fmario/pren_motst/assembly/Schematics_PREN23.PDF

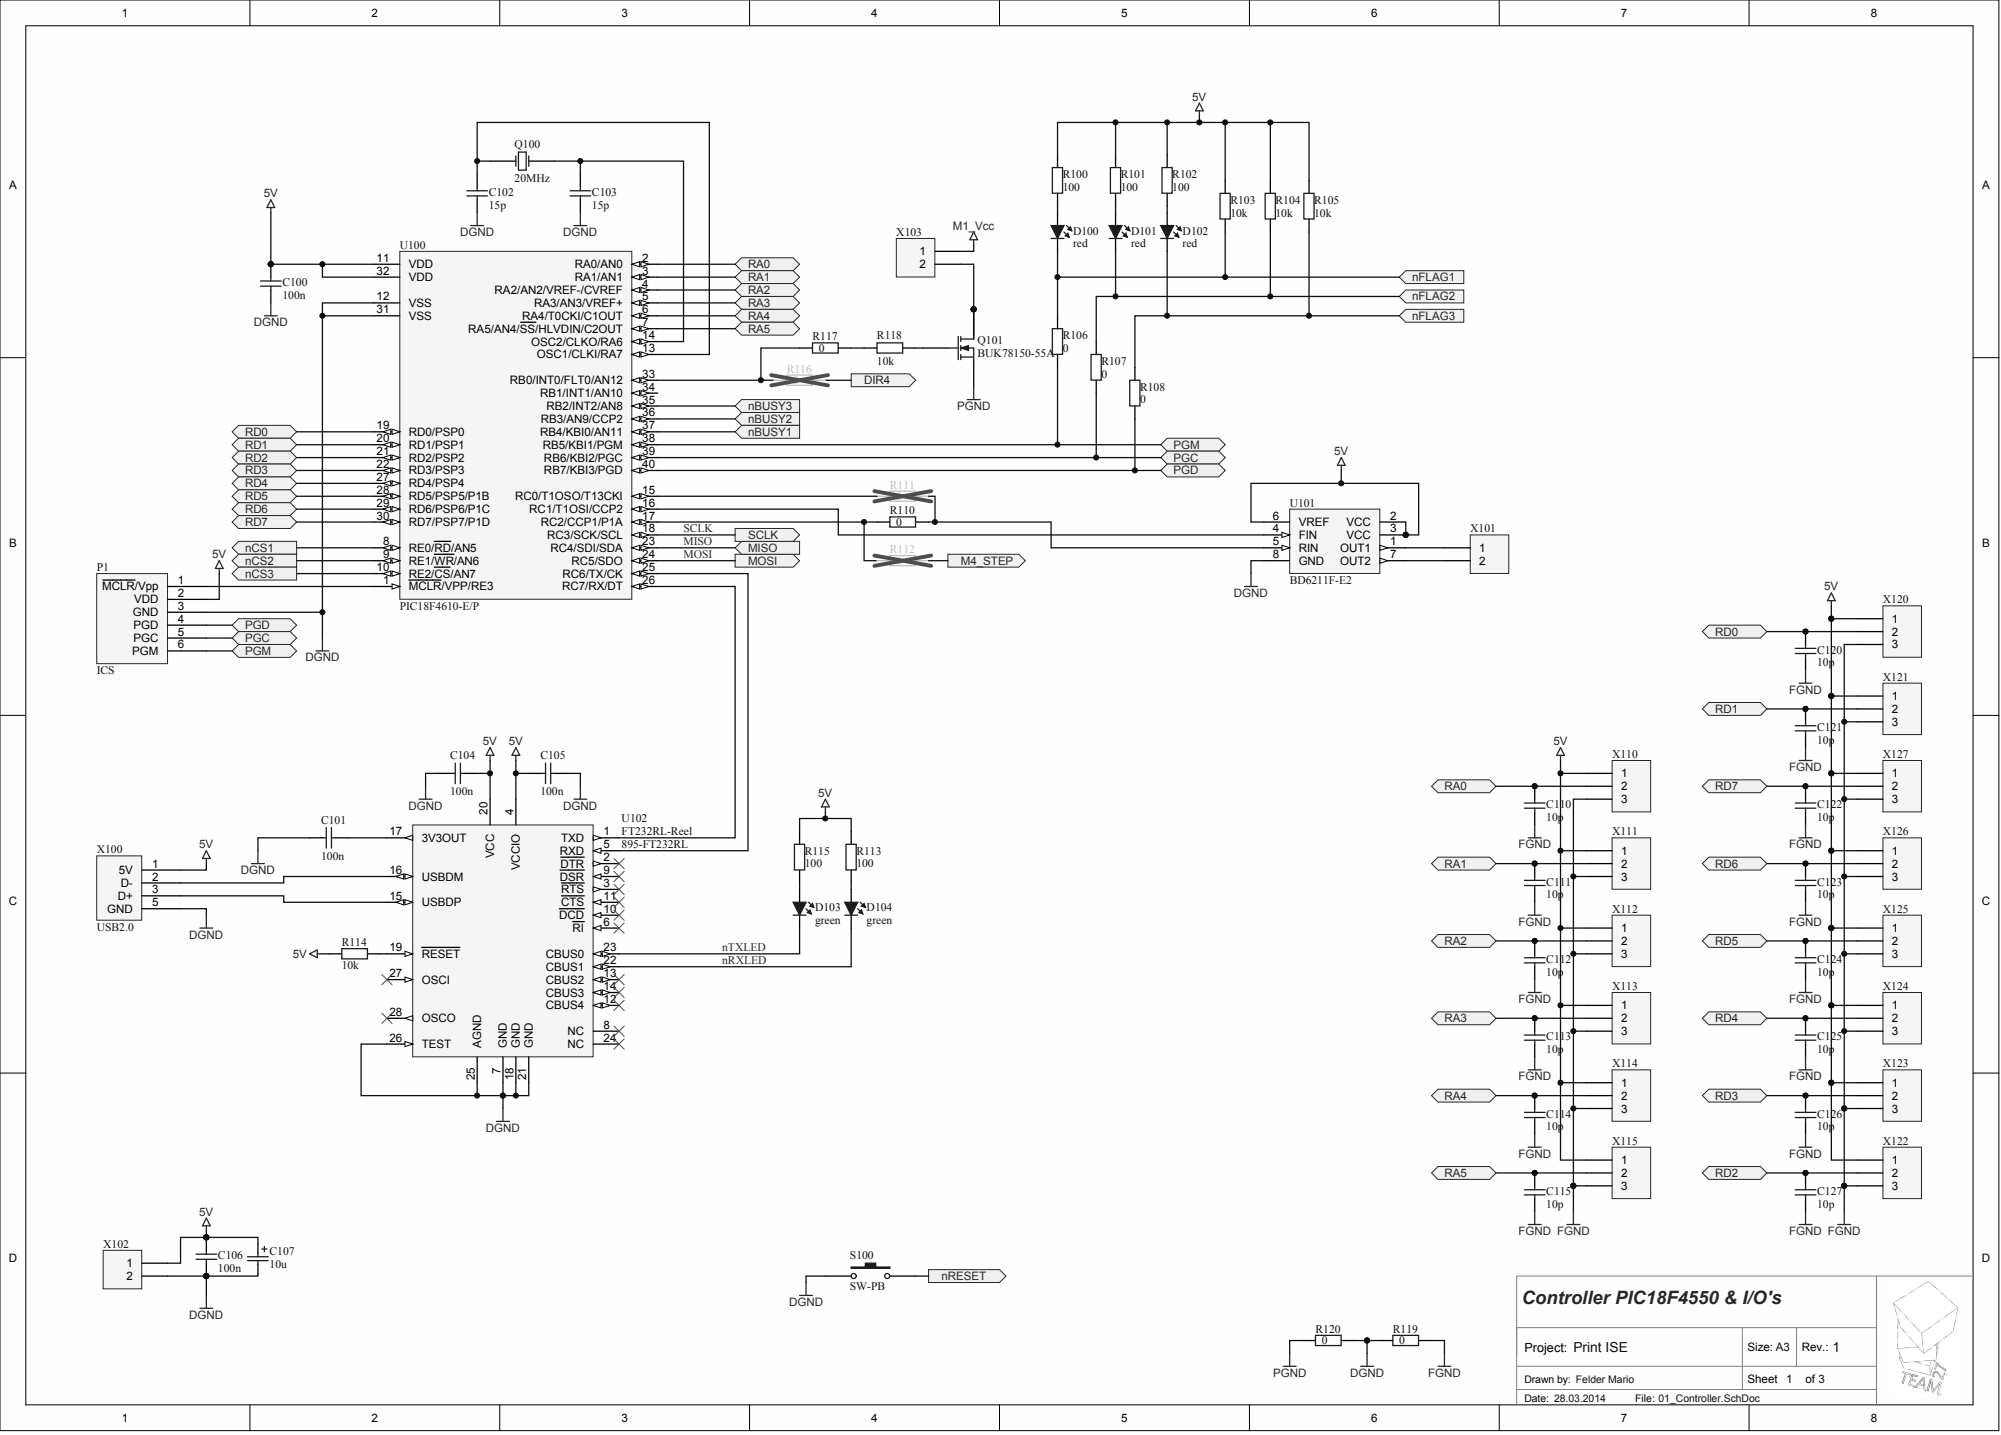
[picture p1: page 1]

20MHz C102 15p | | C103

VDD 11 RA5/AN4/SS/HLVDIN/C2OUT | RA2/AN2/VREF-/CVREF RA3/AN3/VREF+ RA4/T0CKI/C1OUT OSC1/CLKI/RA7 | RA1/AN1
VDD 32 | 3
VSS 12 | | | 4

VSS 31 | | 6
RD0/PSP0 19 RD1/PSP1 20 RD2/PSP2 21 RD3/PSP3 22 RD4/PSP4 27 RD5/PSP5/P1B 28 RD6/PSP6/P1C 29 RD7/PSP7/P1D 30 RE0/RD/AN5 8 RE1/WR/AN6 9 RE2/CS/AN7 10 MCLR/VPP/RE3 1 | 7

13 OSC2/CLKO/RA6 14

Controller PIC18F4550 & I/O's

Print ISE Project: | Size: A3 | 1 Rev.:

Drawn by: Felder Mario

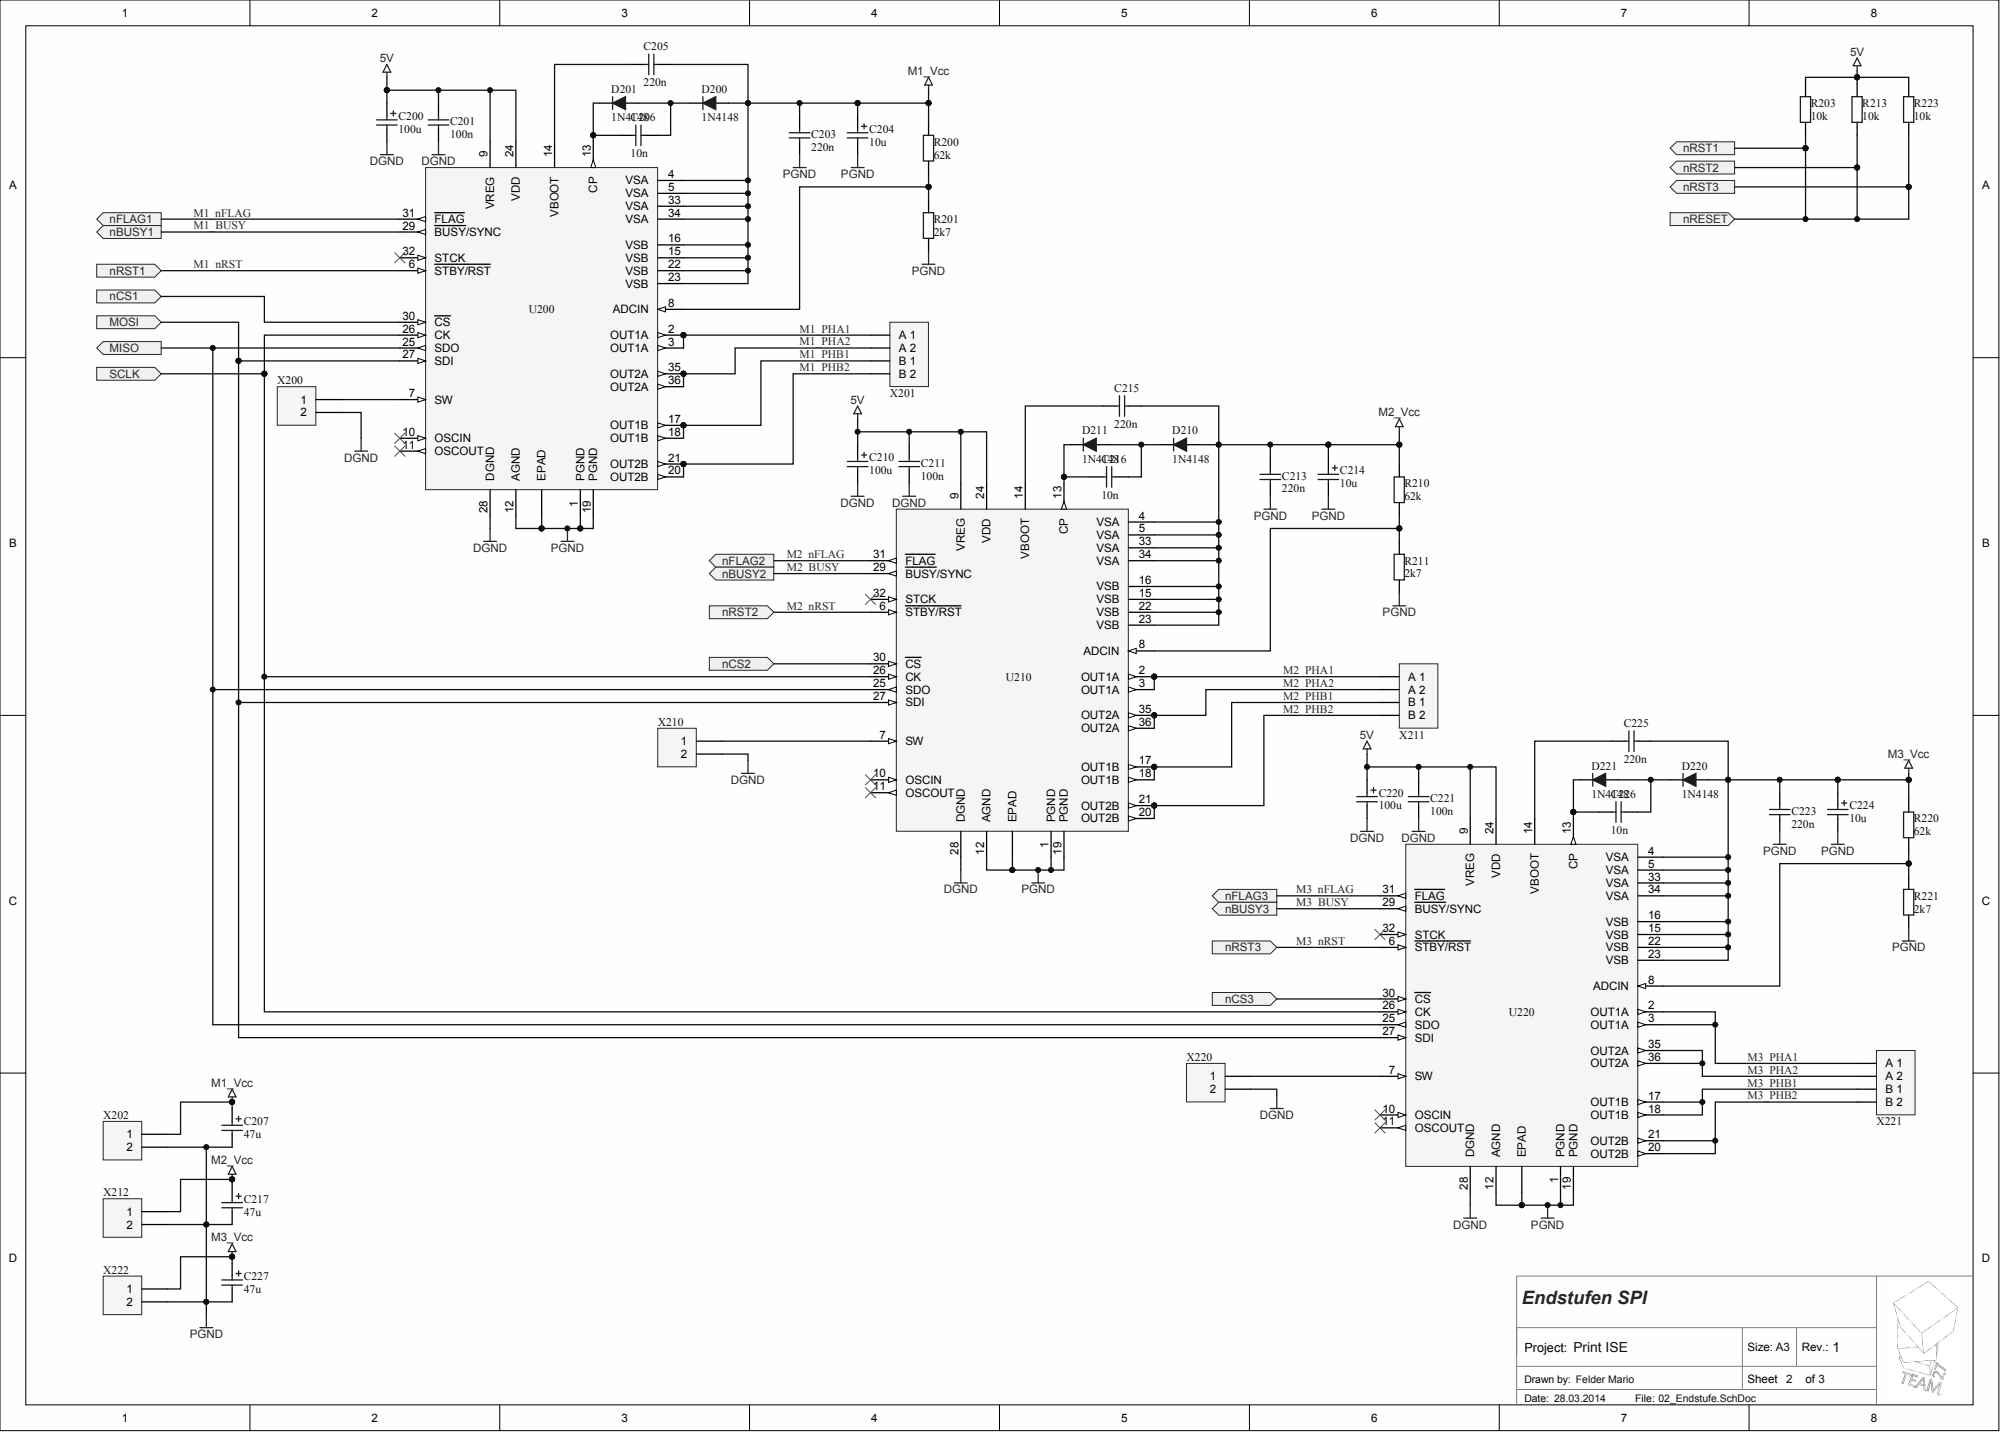
[picture p2: page 2]

SDI 27 | | M1_PHB1 | B 1

OUT2A | 35 | M1_PHB2 | B 2

OSCIN 10 | M3_PHB1

M3_PHB2

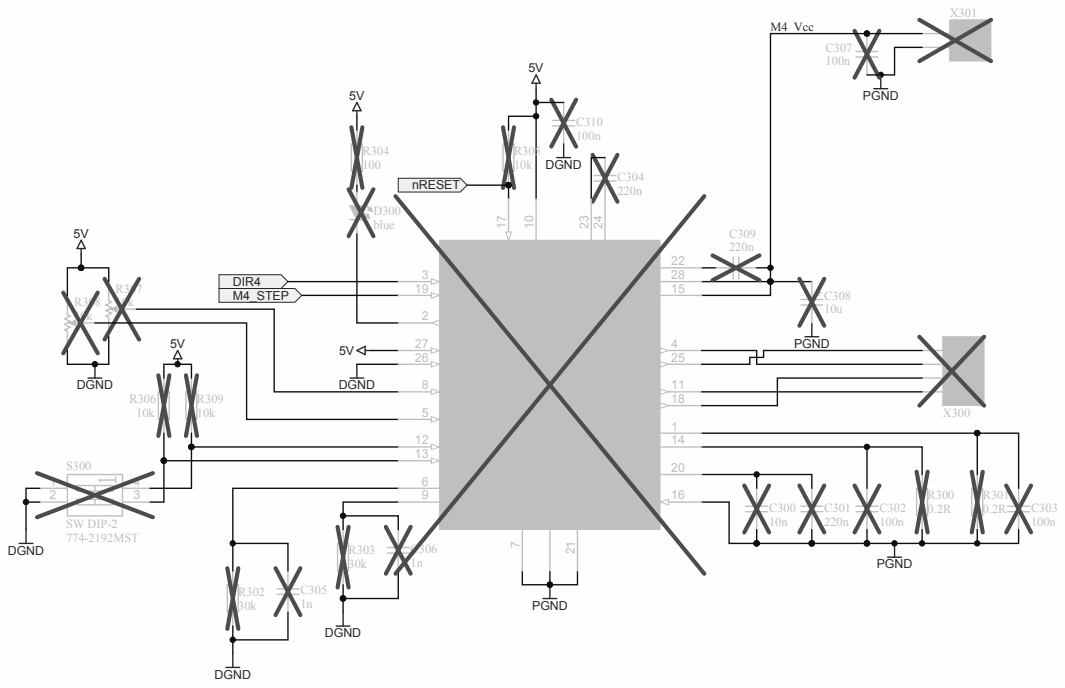
[picture p3: page 3]

DIR 3 | OUT1B U300 A3977SLP | 25 ENABLE 26
STEP 19 HOME 2

5V | SLEEP 27

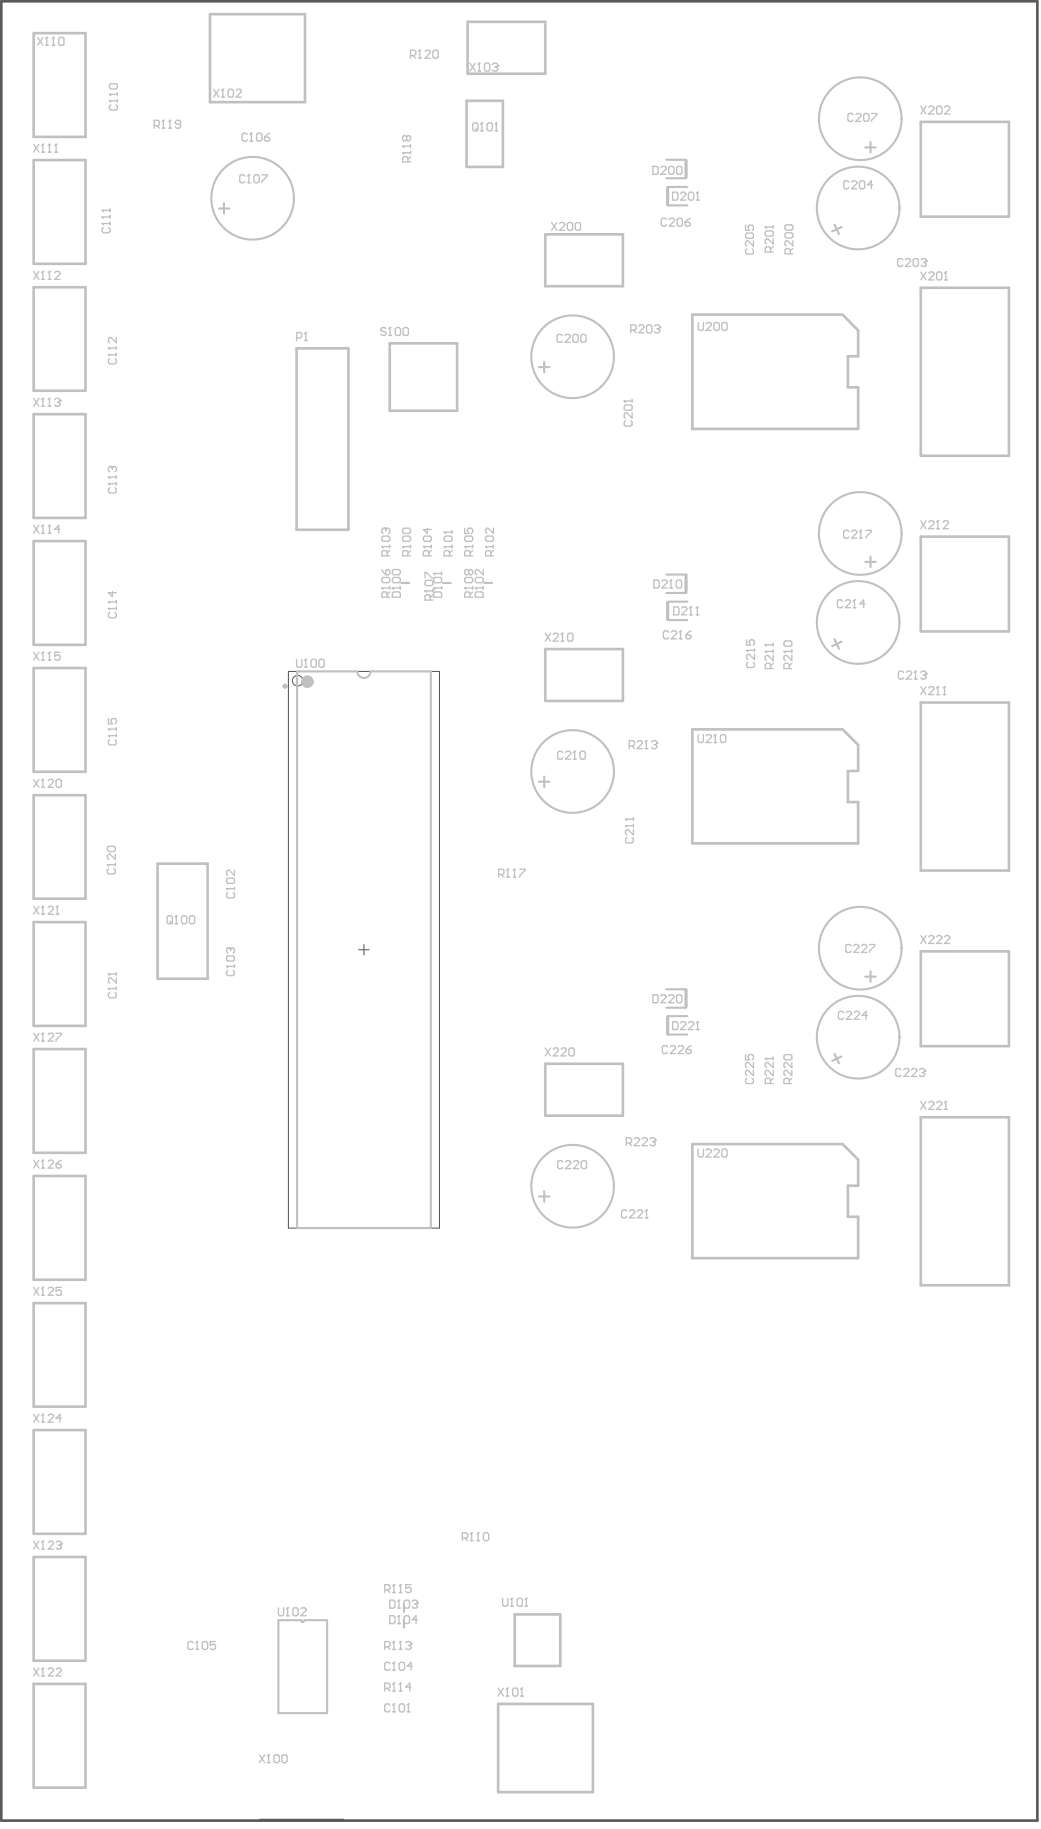
[picture p4: page 4]

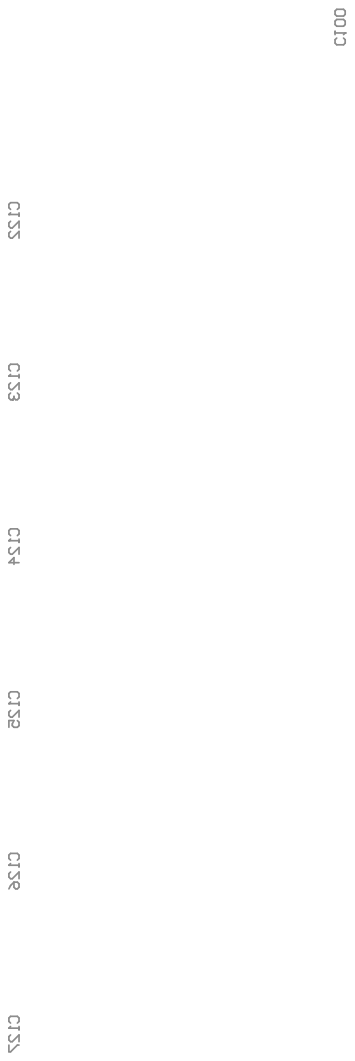
[picture p5: page 5]

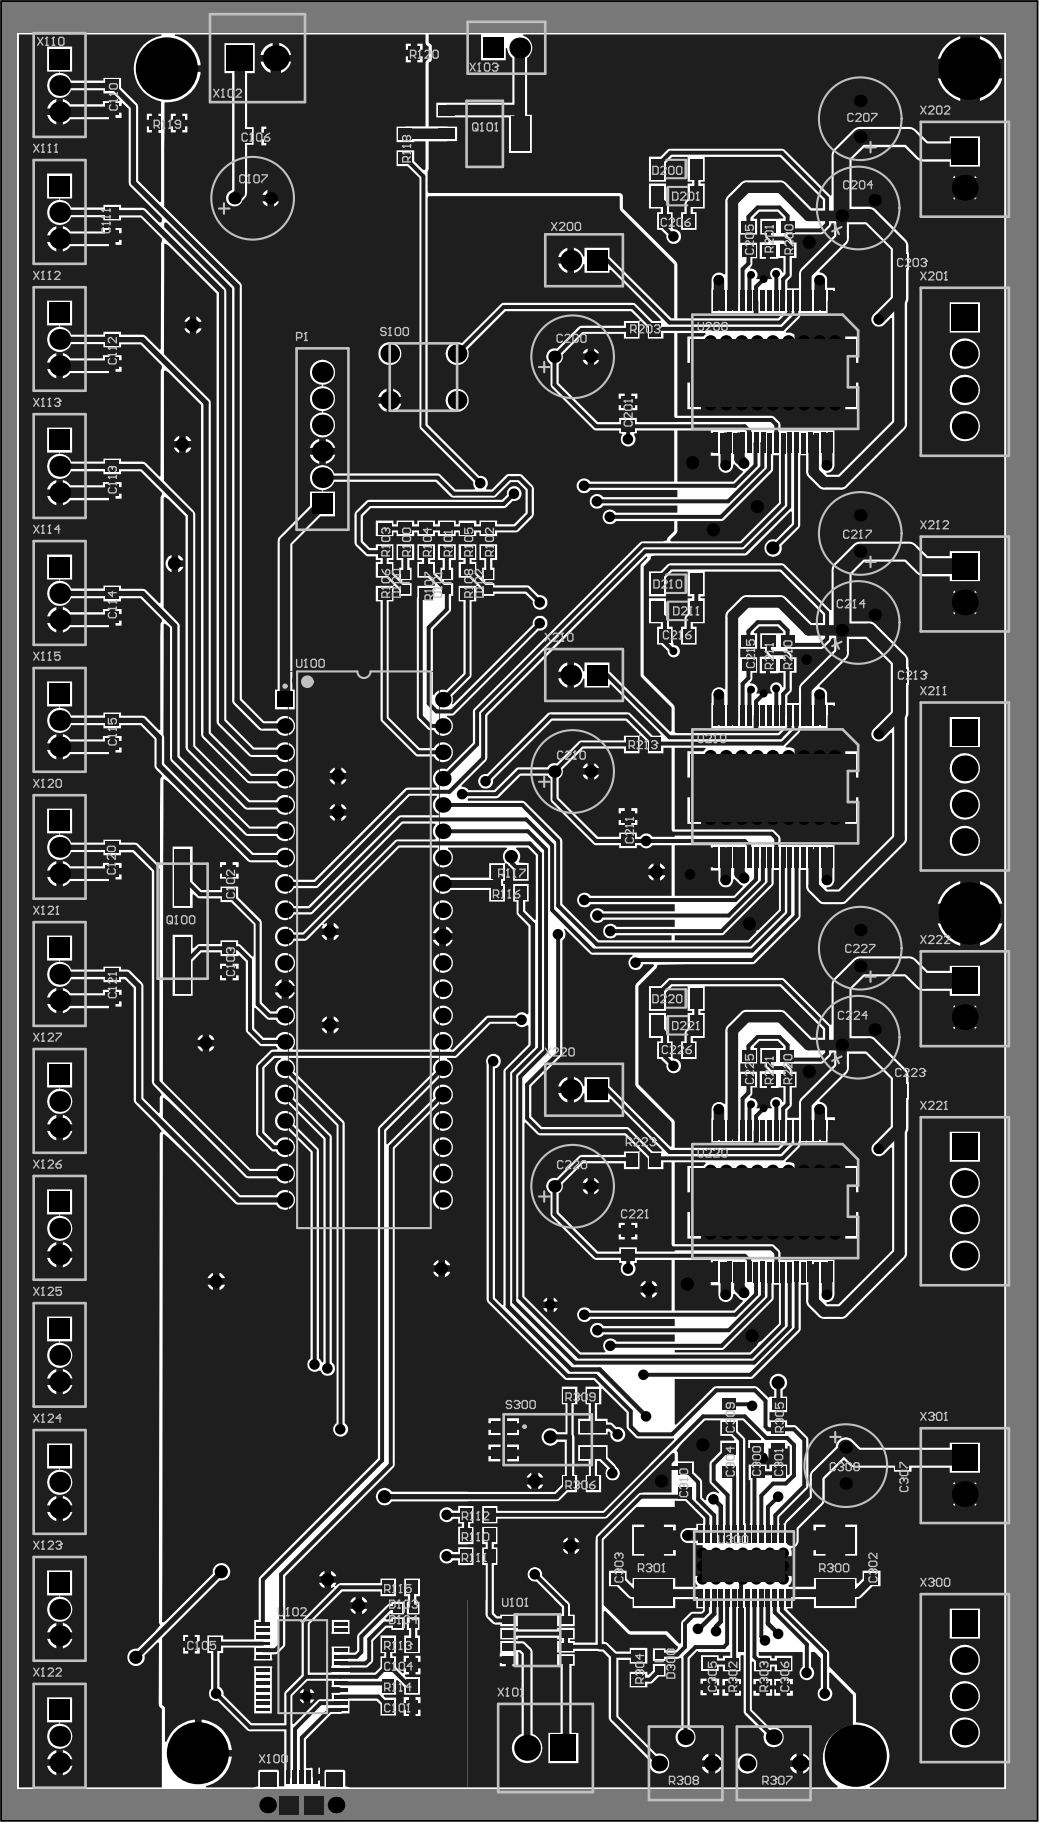
[picture p6: page 6]

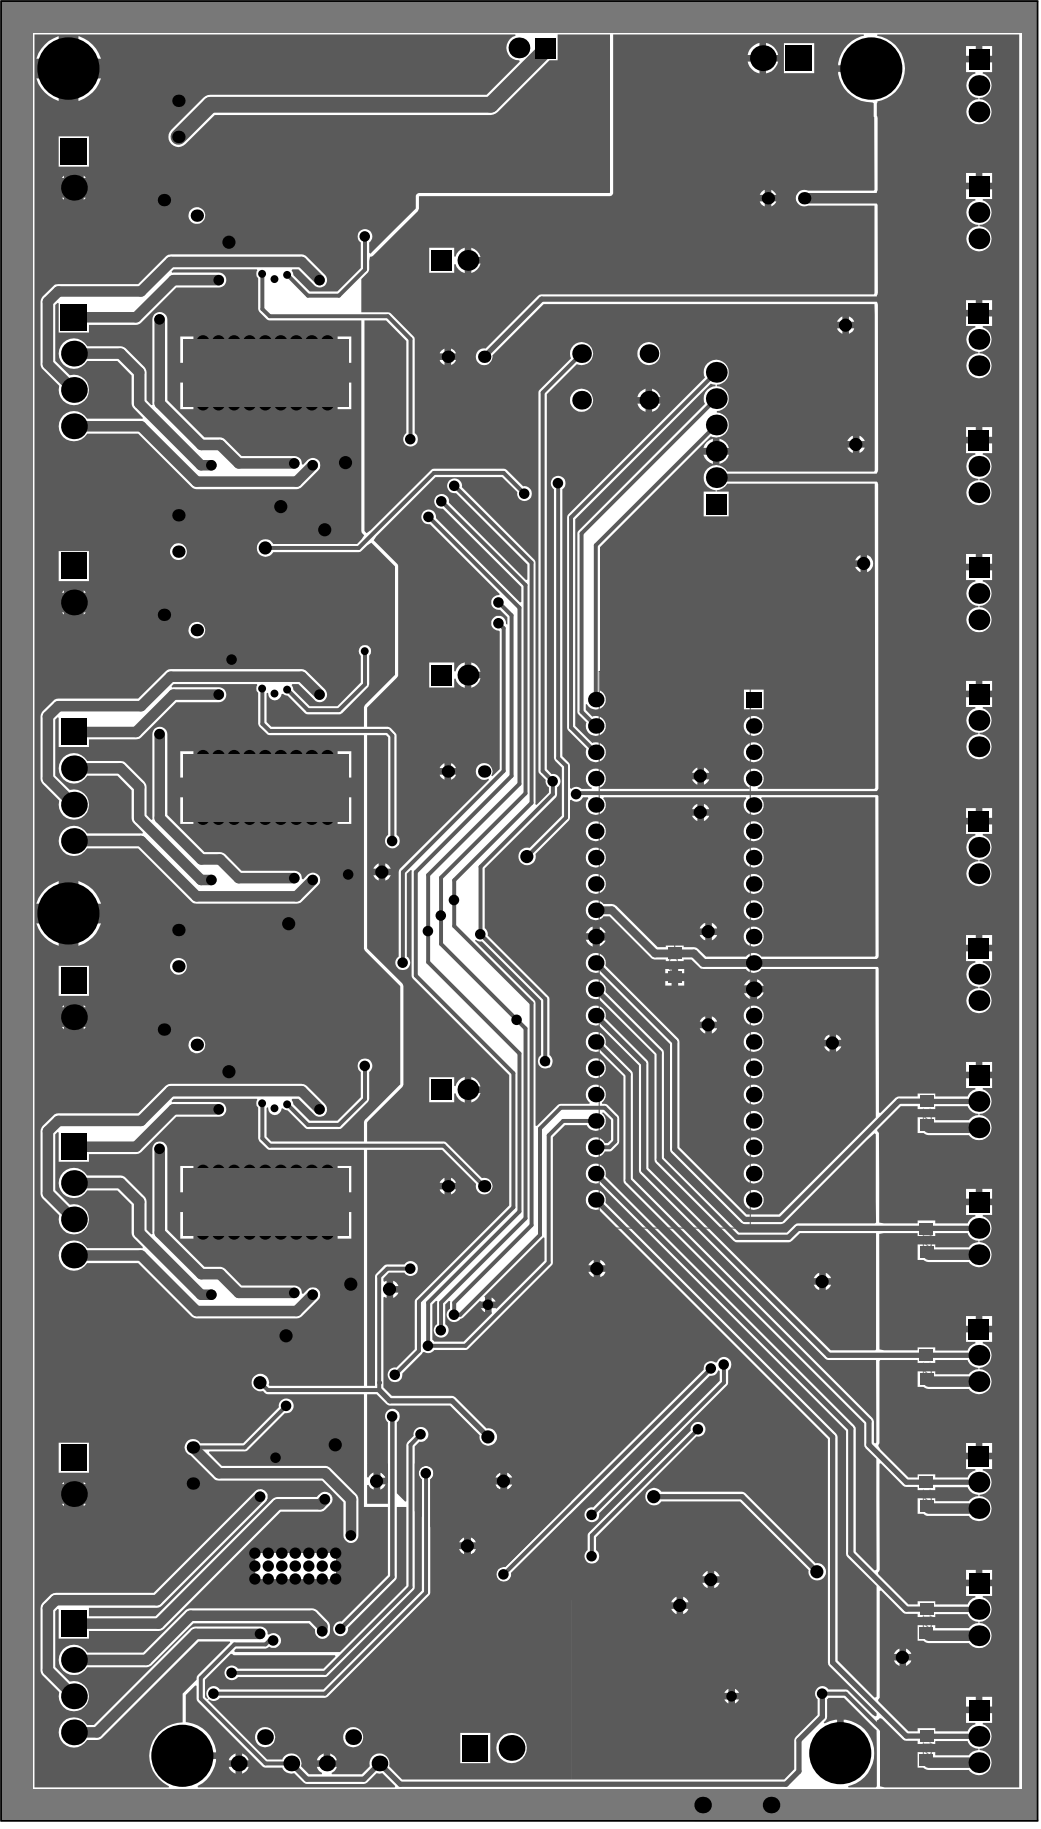
[picture p7: page 7]
