fmario/pren_motst/source/platform/team23.c

/**
*	File:	team23.c
*	Date:	28.05.2014
*	Author:	Fallegger Michi
*
*
*	Version:		0.1
*	Last Change:	-/-
*	History:		-
*
*	Hardware:		PIC18F4610-I/P
*	Compiler:		HI-TECH C Compiler for PIC18 (v9.8)
**/

#ifdef T23

#include <htc.h>

#include "definitions.h"

#include "team23.h"
#include "L6470.h"
#include "A3977.h"

volatile unsigned char* gpio_addr[GPIO] = {	&PRT_A,
											&PRT_A,
											&PRT_A,
											&PRT_A,
											&PRT_A,
											&PRT_A,
											&PRT_D,
											&PRT_D,
											&PRT_D,
											&PRT_D,
											&PRT_D,
											&PRT_D,
											&PRT_D,
											&PRT_B};


volatile unsigned char gpio_offs[GPIO] = {	0,
											1,
											2,
											3,
											4,
											5,
											0,
											1,
											7,
											6,
											5,
											4,
											3,
											0 };
/**
*	Function:	init_motors
*	Parameter:	void
*
*	Description:
*	Initialisiert alle Motoren mit Idealen werten.
**/
void init_motors(void){
	uint8 cAddress;


	/**************************
	**
	** Motor 0 (Arm drehen)
	**
	***************************/
	cAddress = 0;
	L6470_resetDevice(cAddress);
	//L6470_setParam(cAddress, ACC, 0x??);
	//L6470_setParam(cAddress, DEC, 0x??);
	//L6470_setParam(cAddress, MAX_SPEED, 0x10E);
	//L6470_setParam(cAddress, FS_SPD, 0x10E);
	L6470_setParam(cAddress, KVAL_HOLD, 0x1F);	//0.098 x Vs
	L6470_setParam(cAddress, KVAL_RUN, 0x7F);	//0.996 x Vs
	L6470_setParam(cAddress, KVAL_ACC, 0x7F);	//0.496 x Vs
	L6470_setParam(cAddress, KVAL_DEC, 0x7F);	//0.496 x Vs
	//L6470_setParam(cAddress, OCD_TH, OCD_TH_750mA);
	//L6470_setParam(cAddress, STALL_TH, 0x??);
	L6470_setParam(cAddress, STEP_MODE, 0x07);
	L6470_hardStop(cAddress);


	/**************************
	**
	** Motor 1 (Greifer heben/senken)
	**
	***************************/
	cAddress = 1;
	L6470_resetDevice(cAddress);
	//L6470_setParam(cAddress, ACC, 0x??);
	//L6470_setParam(cAddress, DEC, 0x??);
	//L6470_setParam(cAddress, MAX_SPEED, 0x10E);
	//L6470_setParam(cAddress, FS_SPD, 0x10E);
	L6470_setParam(cAddress, KVAL_HOLD, 0x1F);	//0.098 x Vs
	L6470_setParam(cAddress, KVAL_RUN, 0x7F);	//0.996 x Vs
	L6470_setParam(cAddress, KVAL_ACC, 0x7F);	//0.377 x Vs
	L6470_setParam(cAddress, KVAL_DEC, 0x7F);	//0.377 x Vs
	//L6470_setParam(cAddress, OCD_TH, OCD_TH_750mA);
	//L6470_setParam(cAddress, STALL_TH, 0x??);
	L6470_setParam(cAddress, STEP_MODE, 0x07);
	L6470_hardStop(cAddress);


	/**************************
	**
	** Motor 2 (Knickgelenk)
	**
	***************************/
	cAddress = 2;
	L6470_resetDevice(cAddress);
	//L6470_setParam(cAddress, ACC, 0x??);
	//L6470_setParam(cAddress, DEC, 0x??);
	//L6470_setParam(cAddress, MAX_SPEED, 0x??);
	//L6470_setParam(cAddress, FS_SPD, 0x??);
	L6470_setParam(cAddress, KVAL_HOLD, 0x1F);	//0.098 x Vs
	L6470_setParam(cAddress, KVAL_RUN, 0x7F);	//0.996 x Vs
	L6470_setParam(cAddress, KVAL_ACC, 0x7F);	//0.496 x Vs
	L6470_setParam(cAddress, KVAL_DEC, 0x7F);	//0.496 x Vs
	//L6470_setParam(cAddress, OCD_TH, OCD_TH_750mA);
	//L6470_setParam(cAddress, STALL_TH, 0x??);
	L6470_setParam(cAddress, STEP_MODE, 0x07);
	L6470_hardStop(cAddress);


	/**************************
	**
	** DC Motor (Greifer drehen)
	**
	***************************/
	TRISC1 = OUTPUT;	//Reverse
	TRISC2 = OUTPUT;	//Forward
	DC_FW = 1;
	DC_RW = 1;			//HiZ State 

	/**************************
	**
	** Ventil
	**
	***************************/
	TRISB0 = OUTPUT;	//Ventil

}


#endif
