fmario/pren_motst/(commit log)

2014-03-28 Assembly Daten v0.9
    [Print_ISE.GBL, Print_ISE.GTL]
2014-04-03 UART Initialisierung, Daten lesen & schreiben
2014-04-04 Structs für Protokoll UART erstellt
2014-04-04 Interrupt aktivieren & Handler
2014-04-11 Init für SPI geschreiben
2014-04-11 UART ISR hinzugefügt
2014-04-22 Configs hinzugefügt, anpassung in UART Transmit
2014-05-09 Einbindung der Team Header implementiert
2014-05-09 SPI implementiert
2014-05-14 Queue implementiert, Fehler behoben
    [definitions.h, interrupt.c, main.c, protocol.c, protocol.h, queue.c, queue.h, spi.c]
2014-05-16 Protocol Methoden implementiert (SPI Motoren)
2014-05-22 Fehler behoben (Command bei GetStatus)
    [l6470.c]
2014-05-23 CS invertiert, Fehler behoben
    [l6470.c, port.c, protocol.c, spi.c]
2014-05-23 fixed bit length array
    [l6470.c]
2014-05-23 Error fBuffer erst nach kompletem Befehl senden
    [interrupt.c]
2014-05-23 Pin Befehle Implementiert, Motoreninitialisierung hinzugefügt
2014-05-28 Rampe für A3877, ParseParamSend fixed
    [a3977.c, interrupt.c, l6470.c, main.c, team27.c]
2014-05-29 Korrektur bei resetCS, Team23 pin Kommandos implementiert
    [spi.c, team23.c, team23.h]
2014-05-29 SetCS fixed, team23 port fixed
    [spi.c, team23.c]
2014-06-06 fixed motor current, removed dead code
    [protocol.c, team23.c]
2014-06-06 reduced current, made acc,dec and speed more fine granular
